kuyacarlo/tremor-pen/report/Tremor_Cue_Pen_Final_Project.docx

<LOGO>

Tremor Cue Pen: A Tremor-Detecting Pen Attachment with Haptic Feedback

Final Requirements in CPE306: Fundamentals of Mixed Signals and Sensors

Prepared by:

<Your Name>

Submitted to

ENGR. SHEILA MAY M. LIWAG

# Table of Contents

# A. Purpose and Overview

Hand tremor makes handwriting shaky and hard to read. Parkinsonian rest tremor usually sits around 4–6 Hz, and essential tremor, the more common cause of shaky handwriting, runs from about 4 to 12 Hz. The writer often cannot tell exactly when the tremor starts while they are concentrating on the words.

The Tremor Cue Pen is a 3D-printed cylinder that slides over an ordinary ballpen. Inside it, a motion sensor near the tip measures how the pen moves, firmware separates the slow movement of normal writing from the faster shaking of tremor, and a small vibration motor gives the writer a gentle buzz while tremor is present. The cue tells the writer to pause, slow down, or brace the hand.

What it does not do. The pen detects and cues; it does not cancel tremor. A coin vibration motor shakes at roughly 150–250 Hz and cannot push back against a 4–6 Hz movement, so active cancellation would need a different actuator and is outside this project.

## How it works

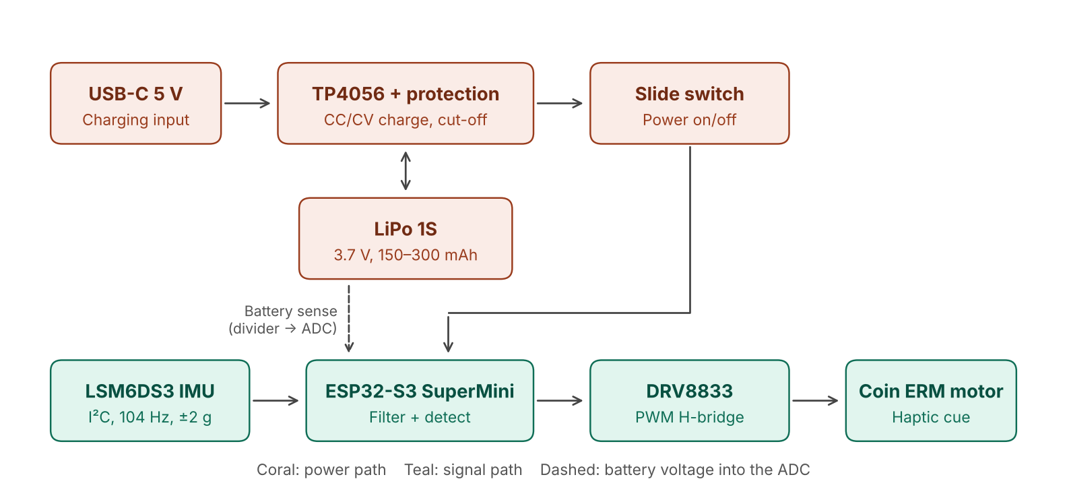
[picture p1: figure]

Figure 1. System block diagram

- Sense. The LSM6DS3 measures acceleration on three axes. Its internal converter samples at 104 Hz with a ±2 g range, and its built-in 50 Hz anti-aliasing filter removes fast vibration before the samples are read over I²C.
- Filter. The ESP32-S3 removes gravity, then runs every axis through two band-pass filters: a stroke band (0.5–3 Hz) for writing movement and a tremor band (4–12 Hz).
- Decide. The power in each band is averaged over about 1 s. Tremor is flagged when the tremor-band power is more than 3 times the stroke-band power and the tremor-band level is above 30 mg for half a second.
- Cue. While tremor is flagged, the ESP32-S3 sends PWM to the DRV8833 motor driver, which runs the coin motor at about one third power.
- Monitor. A voltage divider feeds the battery voltage to the ESP32-S3 ADC. Below 3.4 V the pen gives a three-pulse low-battery pattern.

## Hardware

Part | Role | Notes
ESP32-S3 SuperMini | Sampling, filtering, decision, PWM | Wi-Fi and Bluetooth off, CPU at 80 MHz to cut heat and current
LSM6DS3 6-axis IMU | Acceleration sensing | I²C address 0x6A; gyroscope used only for logging
DRV8833 dual H-bridge | Motor driver | AIN1 from PWM, AIN2 to GND, nSLEEP to 3V3
Coin ERM vibration motor | Haptic cue | 3 V; run at 350 of 1023 PWM because full power is too strong
LiPo 1S cell | Power | With protection PCB
TP4056 charger module | Charging and protection | USB-C input; overcharge and overdischarge cut-off
Slide switch | Power on/off | Between the charger output and the board
2 × 100 kΩ resistors, 100 nF capacitor | Battery sense divider and filter | Halves the battery voltage into the ADC range
3D-printed cylinder | Enclosure | Slides over a ballpen; IMU at the tip end, motor in foam

## Wiring

From | To | ESP32-S3 GPIO
LSM6DS3 SDA | I²C data | GPIO8
LSM6DS3 SCL | I²C clock | GPIO9
LSM6DS3 SDO, CS | GND and 3V3 (selects I²C, address 0x6A) | —
DRV8833 AIN1 | Motor PWM | GPIO4
Battery divider midpoint | ADC1 channel 0 | GPIO1

# B. Scope and Limitations

## Scope

- Detects hand tremor in the 4–12 Hz band in real time while the pen is used, with about 1 s of smoothing and 0.5 s of confirmation.
- Tells tremor apart from normal handwriting and drawing using the ratio of tremor-band to stroke-band power.
- Gives a haptic cue through a coin motor and a low-battery warning pattern.
- Runs on a rechargeable LiPo cell inside a cylinder attachment for a standard ballpen.
- Streams detector values or raw sensor data over USB for logging and analysis.

## Limitations

- Simulated tremor only. Tremor was simulated by deliberately shaking the hand at about 7 Hz. No recordings come from people with Parkinson’s disease or essential tremor, and the device makes no clinical claim.
- Tuned and tested on the same data. Thresholds were chosen on the same five recordings used to report the results, so those results are optimistic until checked on new recordings.
- Prototype rig. The detection recordings were made with the sensor strapped to the wrist on the NodeMCU prototype. The final ESP32-S3 pen uses the same sensor settings and algorithm, but the recordings must be repeated with the sensor in the pen.
- No cancellation. The pen cues the writer and does not reduce the tremor itself.
- False cues. Fast strokes and pen-lift jerks can still produce occasional false cues (about 2.5% of normal writing time).
- Motor feedback risk. The motor vibrates at 150–250 Hz, above the sensor’s 52 Hz Nyquist limit. Any vibration that passes the sensor’s anti-aliasing filter could fold back into the tremor band and keep the motor on. This must be checked with the motor coupling test (Section F).

## Future work

- Cue frequency as a check-up prompt. Counting tremor cues and their total duration over days or weeks could show whether tremor is frequent or getting worse. Above a set level, the pen could suggest that the user consult a physician, who can refer to a neurologist if needed. This would be a prompt to seek care, not a diagnosis, and its threshold would need validation on real users so that fast writers are not flagged. It is outside the scope of this study.

# C. Relevance in Fundamentals of Mixed Signals and Sensors

The project follows one physical quantity, hand acceleration, from a sensor to a digital decision and back out to a physical actuator. Each stage maps to a CPE306 topic.

CPE306 topic | Where it appears in the project
Sensors and transducers | MEMS capacitive accelerometer: a proof mass moves between fixed plates, changing capacitance with acceleration
Signal conditioning | Inside the IMU: charge amplifier, internal ADC, 50 Hz anti-aliasing low-pass; outside: RC filter on the battery divider
Sampling theorem | 104 Hz sampling gives a 52 Hz Nyquist limit, well above the 12 Hz tremor band edge
A/D conversion | IMU 16-bit output (±2 g, 0.061 mg per count); ESP32-S3 12-bit ADC for battery voltage with 16× averaging
D/A conversion | PWM duty cycle sets the average motor voltage (PWM acting as a 1-bit DAC with the motor as the low-pass load)
Digital signal processing | Second-order IIR biquad high-pass and low-pass filters, exponential averaging, ratio decision with hysteresis
Power switching devices | DRV8833 MOSFET H-bridge switched at 20 kHz
Measurement theory and calibration | Gravity reference at start-up, noise floor and 1 g magnitude check, threshold selection from recorded data

## Sensor and signal chain

The LSM6DS3 is a MEMS accelerometer. Acceleration moves a tiny suspended mass, the change in capacitance is converted to a voltage by an internal charge amplifier, filtered by an internal anti-aliasing low-pass, and digitised by the sensor’s own converter. The ESP32-S3 reads the result as 16-bit numbers over I²C, so all analog conditioning for the motion signal happens on the sensor chip. With the ±2 g range, one count is 0.061 mg.

The sensor was set to 104 samples per second. By the sampling theorem the highest frequency it can represent is 52 Hz, about four times the 12 Hz top of the tremor band. The internal 50 Hz anti-aliasing filter attenuates motion above that limit before it can fold back into the band of interest.

## Filtering

Each band-pass is a second-order high-pass followed by a second-order low-pass (Butterworth-like, Q = 0.707), computed from the bilinear-transform biquad formulas at fs = 104 Hz. The stroke band (0.5–3 Hz) holds the slow movement of writing; the tremor band (4–12 Hz) holds the shaking. Gravity is measured at start-up and subtracted from every sample so the filters do not ring at power-on.

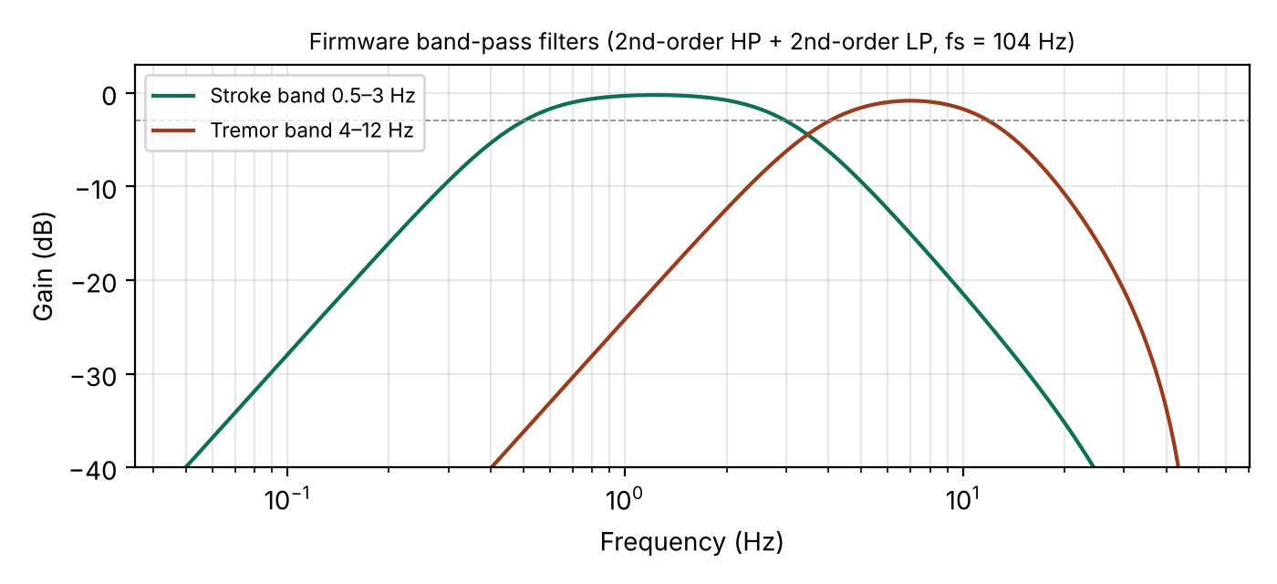
[picture p2: figure]

Figure 2. Frequency response of the two firmware band-pass filters

## Why a ratio and not a threshold

The first version of the firmware turned the motor on whenever the tremor-band level passed a fixed threshold. The recordings showed that normal handwriting itself puts energy in the 4–6 Hz range, so that version fired during 40% of normal writing. Tremor raises the tremor band relative to the stroke band, while writing raises the stroke band. The ratio of the two separates them even when their absolute levels overlap.

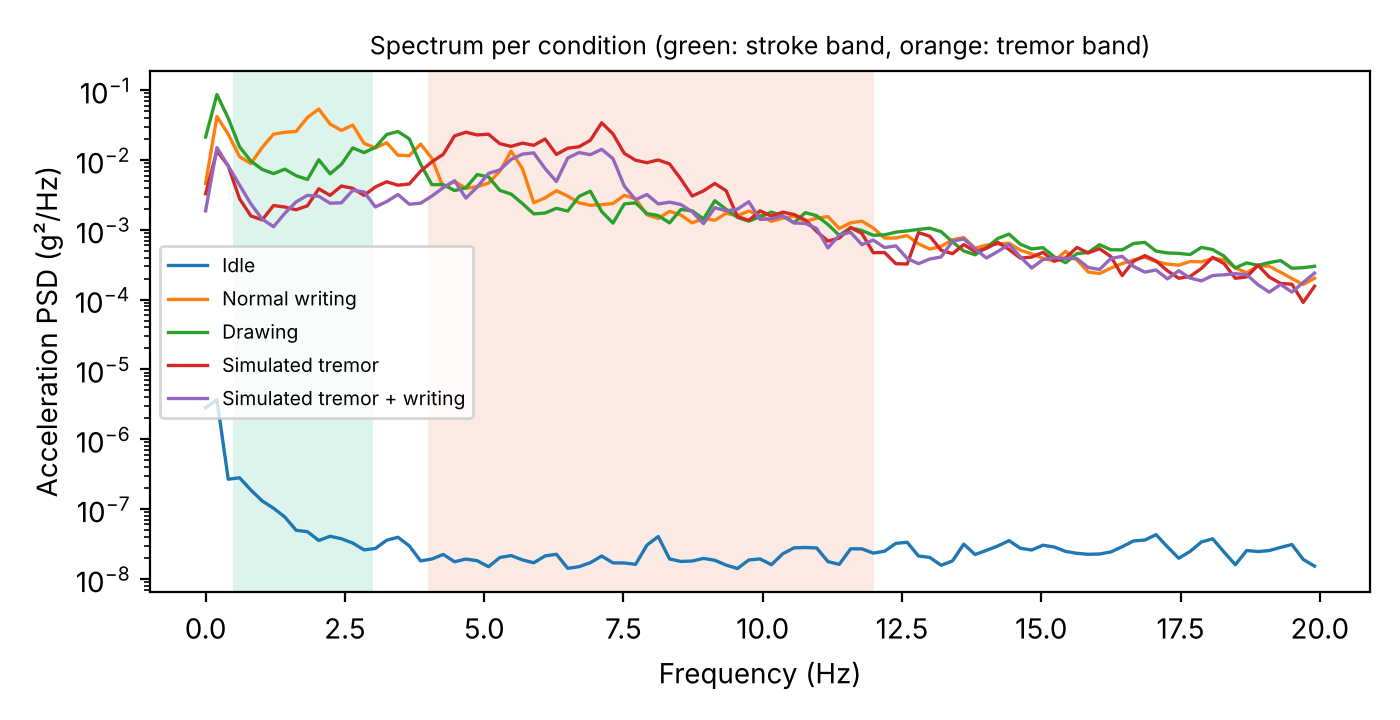
[picture p3: figure]

Figure 3. Acceleration spectrum per recording. Writing peaks inside the stroke band; simulated tremor peaks at about 7 Hz inside the tremor band.

## Analog-to-digital and digital-to-analog stages

Battery voltage (3.0–4.2 V) is above the ESP32-S3 ADC range, so two 100 kΩ resistors halve it and a 100 nF capacitor across the lower resistor filters switching noise. The firmware averages 16 readings, which lowers random noise by a factor of about 4 (2 bits), and reads calibrated millivolts with analogReadMilliVolts(). The divider draws about 21 µA at 4.2 V.

The ESP32-S3 has no DAC. Instead, the motor is driven with a 20 kHz PWM signal. The motor’s winding inductance and rotor inertia average the pulses, so the duty cycle acts as the output level: 350 of 1023 gives an average of about 34% of the supply voltage.

## Calibration and measurement

With the sensor still, the measured acceleration magnitude was 0.978 g against the expected 1 g, an error of about 2.2%. The noise standard deviation was 0.8, 0.6 and 3.7 mg on the three axes, and the tremor-band level at rest was below 1 mg, far under the 30 mg detection gate. Because the detector uses band-pass filtered signals, a constant offset or a gain error of a few percent does not change the decision. A six-orientation calibration (±1 g on each axis) can be added to measure offset and gain per axis.

## Alternatives considered

Decision | Options | Chosen and why
Motion sensor | Analog accelerometer (ADXL335) with external op-amp filter; digital IMU (LSM6DS3) | Digital IMU: built-in anti-aliasing and converter, low noise, I²C with two wires
Detection method | Tremor-band energy threshold; FFT peak frequency; tremor/stroke ratio; gyroscope energy | Ratio: fewest false cues on writing (2.5% vs 40%) and best detection while writing
Actuator | Coin ERM motor; linear resonant actuator (LRA); piezo buzzer | ERM: on hand, strong, simple to drive; LRA needs a dedicated driver
Controller | NodeMCU (ESP8266); ESP32-S3 SuperMini | ESP32-S3 for the final pen: smaller, more ADC channels, native USB; NodeMCU used for the prototype

Comparison of detection methods on the five recordings (percentage of time flagged after a 2.5 s warm-up):

Detector | Idle | Writing | Drawing | Tremor | Tremor + writing
Energy only (>170 mg) | 0% | 40% | 20% | 90% | 40%
Ratio detector | 0% | 2% | 0% | 100% | 82%

# D. User Interfaces

## Writer

The writer uses the pen like any ballpen. The only controls are the power switch and the USB-C charging port; all feedback is through vibration.

Event | What the writer feels | Condition
Power on | Nothing for about 1 s while the pen measures gravity | Hold the pen still at switch-on
Tremor detected | Continuous gentle buzz | Ratio > 3 and level > 30 mg for 0.5 s
Tremor stops | Buzz stops | Ratio < 1.5 or level < 20 mg for 0.5 s
Low battery | Three short pulses about every 10 s | Battery below 3.4 V
Charging | Charger LED on | USB-C connected

## Developer and tester

Over USB, the pen streams one line every 5 samples (about 20 lines per second). The Arduino Serial Plotter draws these as live graphs, and the Python logger saves them as labelled CSV files.

Field | Meaning
band_mg | Tremor-band level (smoothed RMS, mg)
on, off | Start and stop level gates (30 and 20 mg), drawn as reference lines
motor | 20 while the cue is on, 0 otherwise
ratio | Tremor-band ÷ stroke-band power
vbat | Battery voltage (V)

Setting LOG_RAW to 1 switches the stream to raw accelerometer and gyroscope counts for recording new data:

python record.py normal_writing 30 /dev/ttyACM0

# E. Code

Firmware for the ESP32-S3 SuperMini, written for the Arduino-ESP32 core 3.x (board “ESP32S3 Dev Module”, USB CDC On Boot enabled).

Setting | Value | Reason
Sample rate | 104 Hz | Sensor output rate, above twice the 12 Hz band edge
Stroke band | 0.5–3 Hz | Writing and arm movement
Tremor band | 4–12 Hz | Parkinsonian and essential tremor
Smoothing | α = 0.01 (about 1 s) | Longer smoothing reduced false cues
Start rule | Ratio > 3 and level > 30 mg for 0.5 s | Ratio rejects writing; level gate rejects sensor noise
Stop rule | Ratio < 1.5 or level < 20 mg for 0.5 s | Hysteresis prevents on/off chatter
Motor PWM | 350 of 1023 at 20 kHz | Full power is too strong; 20 kHz is silent

tremor_cue_pen.ino

// Tremor Cue Pen - ESP32-S3 SuperMini firmware

// LSM6DS3 accel (I2C) -> two band-pass chains -> tremor/stroke ratio -> DRV8833 PWM -> coin motor

// Arduino-ESP32 core 3.x. Board: "ESP32S3 Dev Module", USB CDC On Boot: Enabled.

#include <Wire.h>

#include <WiFi.h>

// ---------- pins (GPIO numbers, ESP32-S3 SuperMini) ----------

const int PIN_SDA = 8;

const int PIN_SCL = 9;

const int PIN_MOTOR = 4; // DRV8833 AIN1 (AIN2 -> GND, nSLEEP -> 3V3)

const int PIN_VBAT = 1; // ADC1_CH0, battery through 100k/100k divider + 100 nF

// ---------- settings ----------

#define LOG_RAW 0 // 1: stream raw accel/gyro for record.py, 0: stream detector values

const int IMU = 0x6A;

const float FS = 104.0f;

const float ALPHA = 0.01f; // power smoothing, time constant ~1 s

const float ON_RATIO = 3.0f, ON_MG = 30.0f;

const float OFF_RATIO = 1.5f, OFF_MG = 20.0f;

const int HOLD = (int)(0.5f * FS); // 0.5 s confirmation

const int MOTOR_PWM = 350; // of 1023

const float VBAT_LOW = 3.40f; // volts

const unsigned long PERIOD_US = (unsigned long)(1e6f / FS);

// ---------- 2nd-order biquad (RBJ, Q = 0.707) ----------

struct Biquad {

float b0, b1, b2, a1, a2, z1 = 0, z2 = 0;

void set(bool hp, float f) {

float w = 2 * PI * f / FS, c = cosf(w), al = sinf(w) / (2 * 0.707f), a0 = 1 + al;

if (hp) { b0 = (1 + c) / 2; b1 = -(1 + c); } else { b0 = (1 - c) / 2; b1 = 1 - c; }

b2 = b0; b0 /= a0; b1 /= a0; b2 /= a0; a1 = -2 * c / a0; a2 = (1 - al) / a0;

z1 = z2 = 0;

}

float run(float x) {

float y = b0 * x + z1;

z1 = b1 * x - a1 * y + z2;

z2 = b2 * x - a2 * y;

return y;

}

};

struct BandPass {

Biquad hp, lp;

void set(float lo, float hi) { hp.set(true, lo); lp.set(false, hi); }

float run(float x) { return lp.run(hp.run(x)); }

};

BandPass tremorBP[3], strokeBP[3];

float g0[3]; // gravity reference, removed before filtering (primes the filters)

float pTremor = 0, pStroke = 0;

bool flagged = false;

int holdCount = 0;

unsigned long nextT;

int16_t lastRaw[3]; int frozenCount = 0;

// ---------- IMU ----------

void wr(uint8_t reg, uint8_t v) {

Wire.beginTransmission(IMU); Wire.write(reg); Wire.write(v); Wire.endTransmission();

}

bool rd(uint8_t reg, uint8_t *buf, int n) {

Wire.beginTransmission(IMU); Wire.write(reg);

if (Wire.endTransmission(false) != 0) return false;

if (Wire.requestFrom(IMU, n) != n) return false;

for (int i = 0; i < n; i++) buf[i] = Wire.read();

return true;

}

bool imuInit() {

uint8_t id = 0;

if (!rd(0x0F, &id, 1) || (id != 0x69 && id != 0x6A)) { Serial.printf("bad WHO_AM_I 0x%02X\n", id); return false; }

wr(0x12, 0x44); // CTRL3_C: auto-increment, block data update

wr(0x10, 0x43); // CTRL1_XL: 104 Hz, +/-2 g, 50 Hz anti-alias bandwidth

wr(0x11, 0x40); // CTRL2_G: gyro 104 Hz, 245 dps (logging only)

return true;

}

bool readIMU(int16_t a[3], int16_t g[3]) {

uint8_t b[12];

if (!rd(0x22, b, 12)) return false; // OUTX_L_G .. OUTZ_H_XL

for (int i = 0; i < 3; i++) {

g[i] = (int16_t)((b[2 * i + 1] << 8) | b[2 * i]);

a[i] = (int16_t)((b[2 * i + 7] << 8) | b[2 * i + 6]);

}

return true;

}

void resetFilters() {

for (int i = 0; i < 3; i++) { tremorBP[i].set(4.0f, 12.0f); strokeBP[i].set(0.5f, 3.0f); }

// average 32 samples to get the gravity reference

float s[3] = {0, 0, 0}; int n = 0; int16_t a[3], g[3];

while (n < 32) { if (readIMU(a, g)) { for (int i = 0; i < 3; i++) s[i] += a[i] * 0.000061f; n++; } delay(10); }

for (int i = 0; i < 3; i++) g0[i] = s[i] / n;

pTremor = pStroke = 0; flagged = false; holdCount = 0;

}

// ---------- battery (ADC) ----------

float readVbat() {

uint32_t mv = 0;

for (int i = 0; i < 16; i++) mv += analogReadMilliVolts(PIN_VBAT); // 16x averaging

return (mv / 16.0f) * 2.0f / 1000.0f; // undo 1:2 divider

}

void setup() {

WiFi.mode(WIFI_OFF);

btStop();

setCpuFrequencyMhz(80);

Serial.begin(115200);

delay(500);

Wire.begin(PIN_SDA, PIN_SCL);

Wire.setClock(400000);

analogReadResolution(12);

analogWriteResolution(PIN_MOTOR, 10);

analogWriteFrequency(PIN_MOTOR, 20000); // above hearing

analogWrite(PIN_MOTOR, 0);

while (!imuInit()) delay(500);

resetFilters();

nextT = micros();

}

void loop() {

if ((long)(micros() - nextT) < 0) return;

nextT += PERIOD_US;

int16_t a[3], g[3];

if (!readIMU(a, g)) { Serial.println("i2c fail"); analogWrite(PIN_MOTOR, 0); delay(100); imuInit(); resetFilters(); nextT = micros(); return; }

bool same = a[0] == lastRaw[0] && a[1] == lastRaw[1] && a[2] == lastRaw[2];

frozenCount = same ? frozenCount + 1 : 0;

memcpy(lastRaw, a, sizeof(lastRaw));

if (frozenCount > 50) { Serial.println("frozen, reinit"); imuInit(); resetFilters(); frozenCount = 0; nextT = micros(); return; }

#if LOG_RAW

Serial.printf("raw,%lu,%d,%d,%d,%d,%d,%d\n", millis(), a[0], a[1], a[2], g[0], g[1], g[2]);

#endif

float eT = 0, eS = 0;

for (int i = 0; i < 3; i++) {

float x = a[i] * 0.000061f - g0[i]; // g, gravity removed

float yt = tremorBP[i].run(x), ys = strokeBP[i].run(x);

eT += yt * yt; eS += ys * ys;

}

pTremor += ALPHA * (eT - pTremor);

pStroke += ALPHA * (eS - pStroke);

float rmsMg = sqrtf(pTremor) * 1000.0f;

float ratio = pTremor / (pStroke + 1e-12f);

if (!flagged) {

holdCount = (ratio > ON_RATIO && rmsMg > ON_MG) ? holdCount + 1 : 0;

if (holdCount >= HOLD) { flagged = true; holdCount = 0; }

} else {

holdCount = (ratio < OFF_RATIO || rmsMg < OFF_MG) ? holdCount + 1 : 0;

if (holdCount >= HOLD) { flagged = false; holdCount = 0; }

}

static uint32_t n = 0; n++;

static float vbat = 4.0f;

if (n % 104 == 0) vbat = readVbat(); // once per second

bool low = vbat < VBAT_LOW;

// low battery: three short pulses every ~10 s instead of tremor cues

int duty = 0;

if (low) { uint32_t k = n % 1040; duty = (k < 10 || (k > 20 && k < 30) || (k > 40 && k < 50)) ? MOTOR_PWM : 0; }

else duty = flagged ? MOTOR_PWM : 0;

analogWrite(PIN_MOTOR, duty);

#if !LOG_RAW

if (n % 5 == 0)

Serial.printf("band_mg:%.1f,on:%d,off:%d,motor:%d,ratio:%.2f,vbat:%.2f\n", rmsMg, (int)ON_MG, (int)OFF_MG, flagged ? 20 : 0, ratio, vbat);

#endif

}

record.py (data logger)

#!/usr/bin/env python3

"""Usage: python record.py <label> [seconds=30] [port=/dev/ttyUSB0]

Logs either sketch mode:

LOG_RAW 1 -> <label>_raw_<ts>.csv (label,t_pc,t_ms,ax,ay,az,gx,gy,gz raw LSB)

LOG_RAW 0 -> <label>_band_<ts>.csv (label,elapsed_s,band_mg,on,off,motor)

"""

import csv, sys, time

import serial

label = sys.argv[1] if len(sys.argv) > 1 else "normal_writing"

duration = float(sys.argv[2]) if len(sys.argv) > 2 else 30

port = sys.argv[3] if len(sys.argv) > 3 else "/dev/ttyUSB0"

ts = int(time.time())

RAW_HDR = ["label", "t_pc", "t_ms", "ax", "ay", "az", "gx", "gy", "gz"]

BAND_HDR = ["label", "elapsed_s", "band_mg", "on", "off", "motor"]

with serial.Serial(port, 115200, timeout=0.2) as s:

time.sleep(2) # let the board settle after the port opens

s.reset_input_buffer() # drop backlog so t=0 is really t=0

s.readline() # discard a possibly partial line

t0 = time.monotonic()

next_status = 0.0

f = writer = None

n = 0

try:

while True:

el = time.monotonic() - t0

if el >= duration:

break

if el >= next_status:

print(f"\rRecording {label}: {max(0, duration-el):4.1f}s left, {n} rows", end="", flush=True)

next_status = el + 0.5

line = s.readline().decode(errors="ignore").strip()

row = None

if line.startswith("raw,"):

p = line.split(",")

if len(p) == 8:

try:

[int(x) for x in p[1:]]

except ValueError:

continue

row = ("raw", [label, f"{el:.3f}"] + p[1:])

elif line.startswith("band_mg:"):

try:

d = dict(i.split(":", 1) for i in line.split(","))

row = ("band", [label, f"{el:.2f}", d["band_mg"], d["on"], d["off"], d["motor"]])

except (ValueError, KeyError):

continue

if row is None:

if line:

print(f"\n[{line}]") # surface 'i2c fail', 'frozen, reinit', 'bad WHO_AM_I'

continue

if writer is None:

kind = row[0]

fn = f"{label}_{kind}_{ts}.csv"

f = open(fn, "w", newline="")

writer = csv.writer(f)

writer.writerow(RAW_HDR if kind == "raw" else BAND_HDR)

writer.writerow(row[1]); n += 1

except KeyboardInterrupt:

print("\nInterrupted.")

finally:

if f:

f.close()

print(f"\nSaved {fn if writer else '(nothing - no data lines seen)'} ({n} rows)")

# F. Use/Test Cases (Testing)

Five 30 s recordings were made with the sensor strapped to the wrist (NodeMCU prototype, same sensor settings). The firmware’s filters and decision rules were then replayed on the raw data. Percentages are the share of time the cue was on, after a 2.5 s warm-up.

ID | Test case | Expected | Result | Status
TC1 | Pen at rest on the table | No cue (0%) | 0% | Pass
TC2 | Normal handwriting | Cue ≤ 5% of the time | 2.5% | Pass
TC3 | Drawing shapes | Cue ≤ 5% of the time | 0% | Pass
TC4 | Simulated tremor, no writing | Cue ≥ 90% of the time | 100% | Pass
TC5 | Simulated tremor while writing | Cue ≥ 70% of the time | 82% | Pass
TC6 | Two new writing runs (new words), held out | Cue ≤ 5% | Pending | Pending
TC7 | Weak simulated tremor, held out | Cue ≥ 50% | Pending | Pending
TC8 | Motor forced on, pen still | Ratio and level stay below start rule | Pending | Pending
TC9 | TC1–TC5 repeated with sensor in the pen cylinder | Same limits as TC1–TC5 | Pending | Pending
TC10 | Battery below 3.4 V (bench supply) | Three-pulse pattern | Pending | Pending
TC11 | Unplug IMU while running, then reconnect | Motor off, sensor re-initialised | Pending | Pending

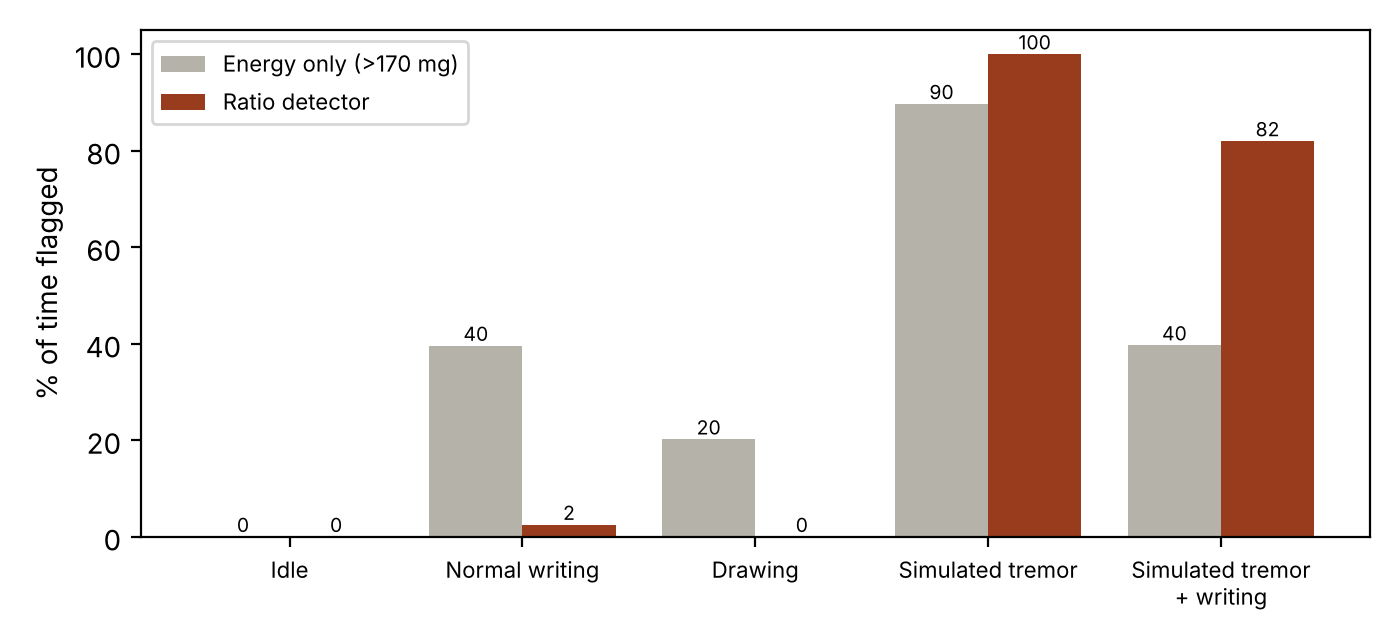
[picture p4: figure]

Figure 4. Share of time flagged: energy-only threshold against the ratio detector

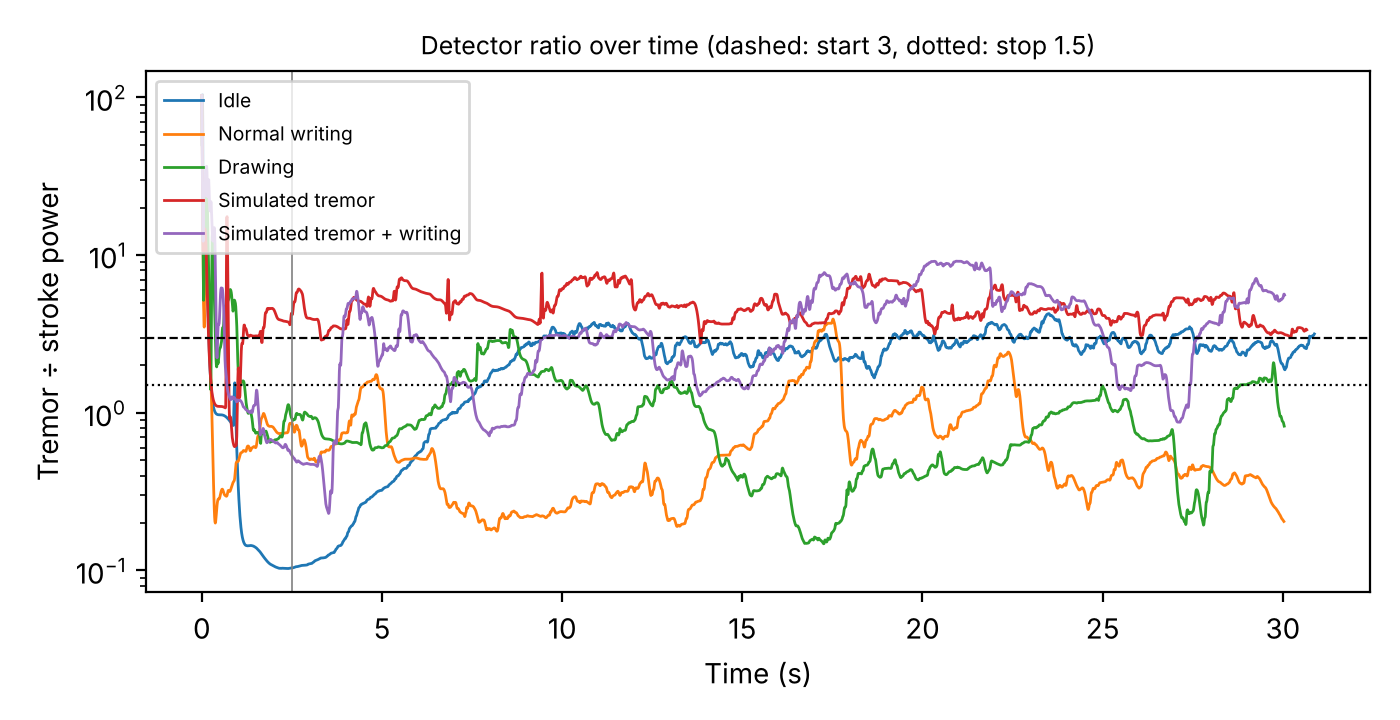
[picture p5: figure]

Figure 5. Detector ratio over each 30 s recording. Simulated tremor stays above the start line; writing and drawing stay below it.

## Signal summary per recording

Recording | Dominant frequency | Median ratio | Median tremor-band level
Idle | 0.6 Hz | 2.62 | 0.4 mg
Normal writing | 2.0 Hz | 0.49 | 154.2 mg
Drawing | 3.5 Hz | 0.78 | 116.8 mg
Simulated tremor | 7.1 Hz | 4.69 | 254.7 mg
Simulated tremor + writing | 7.1 Hz | 3.12 | 141.6 mg

At rest the ratio is around 2–3 because both bands contain only sensor noise, which is why the 30 mg level gate is part of the start rule: the tremor-band level at rest is under 1 mg, so the pen never cues while idle.

The simulated tremor peaks at about 7 Hz, the shaking rate used during recording, while normal writing peaks at 2 Hz inside the stroke band. All recordings ran at about 104 Hz with no lost samples.

Tremor Cue Pen
