kuyacarlo/tremor-pen/cad/stl/tremor_pen_pod_v7-cap.stl

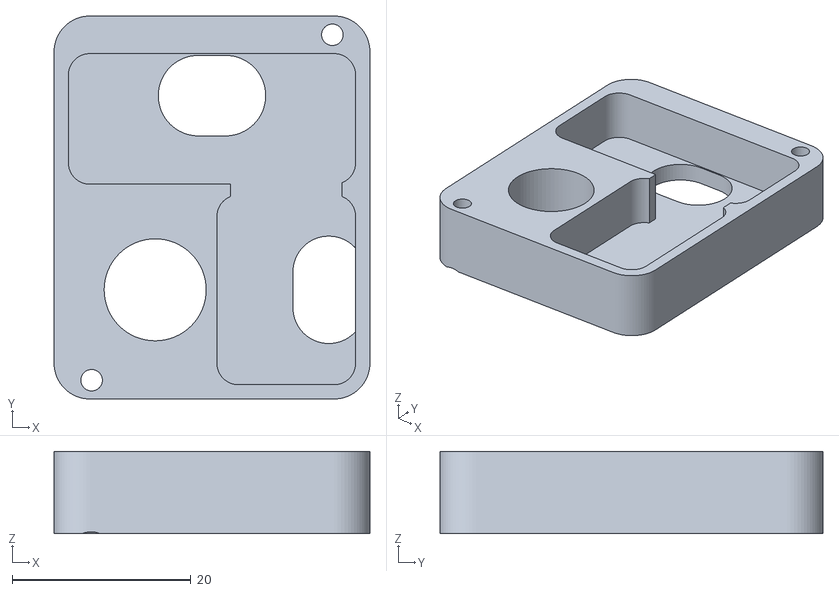
[picture p6: CAD file, 2026-11-03]
cad/stl/tremor_pen_pod_v7-cap.stl
35.3 x 42.8 x 9.20
