kuyacarlo/tremor-pen/cad/stl/tremor_pen_pod_v5-cover.stl

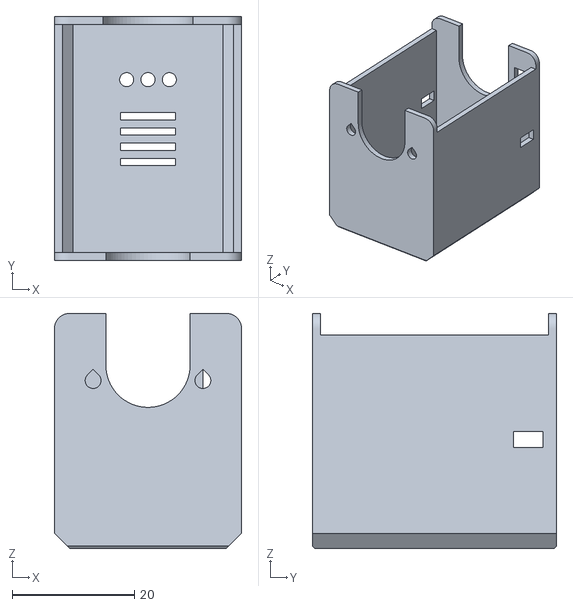
[picture p8: CAD file, 2026-11-03]
cad/stl/tremor_pen_pod_v5-cover.stl
30.7 x 40.0 x 38.5
