kuyacarlo/tremor-pen/cad/stl/tremor_pen_pod_v5-base.stl

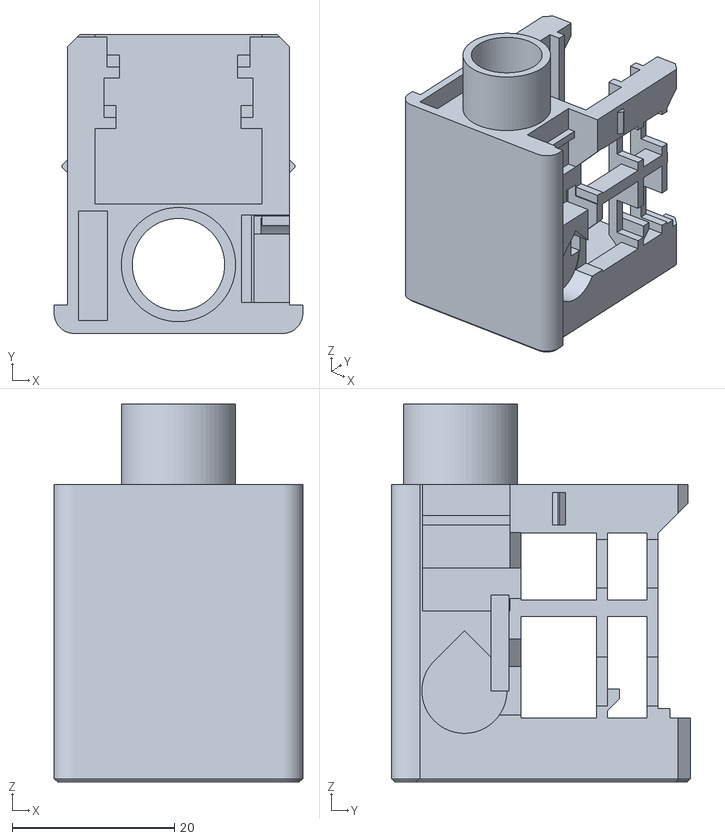
[picture p9: CAD file, 2026-11-03, an earlier design]
cad/stl/tremor_pen_pod_v5-base.stl
30.7 x 36.9 x 46.7
