kuyacarlo/tremor-pen/(list of files, cad)

Other CAD files:
cad/tremor_pen_pod_v5.scad
cad/archive/tremor_pen_pod_b.scad
cad/archive/tremor_pen_pod_v3_1.scad
cad/archive/tremor_pen_pod_v4.scad
cad/archive/tremor_pen_pod_v5.scad
cad/archive/tremor_pen_pod_v6.scad
