kuyacarlo/tremor-pen/cad/guide/assembly_v5.png

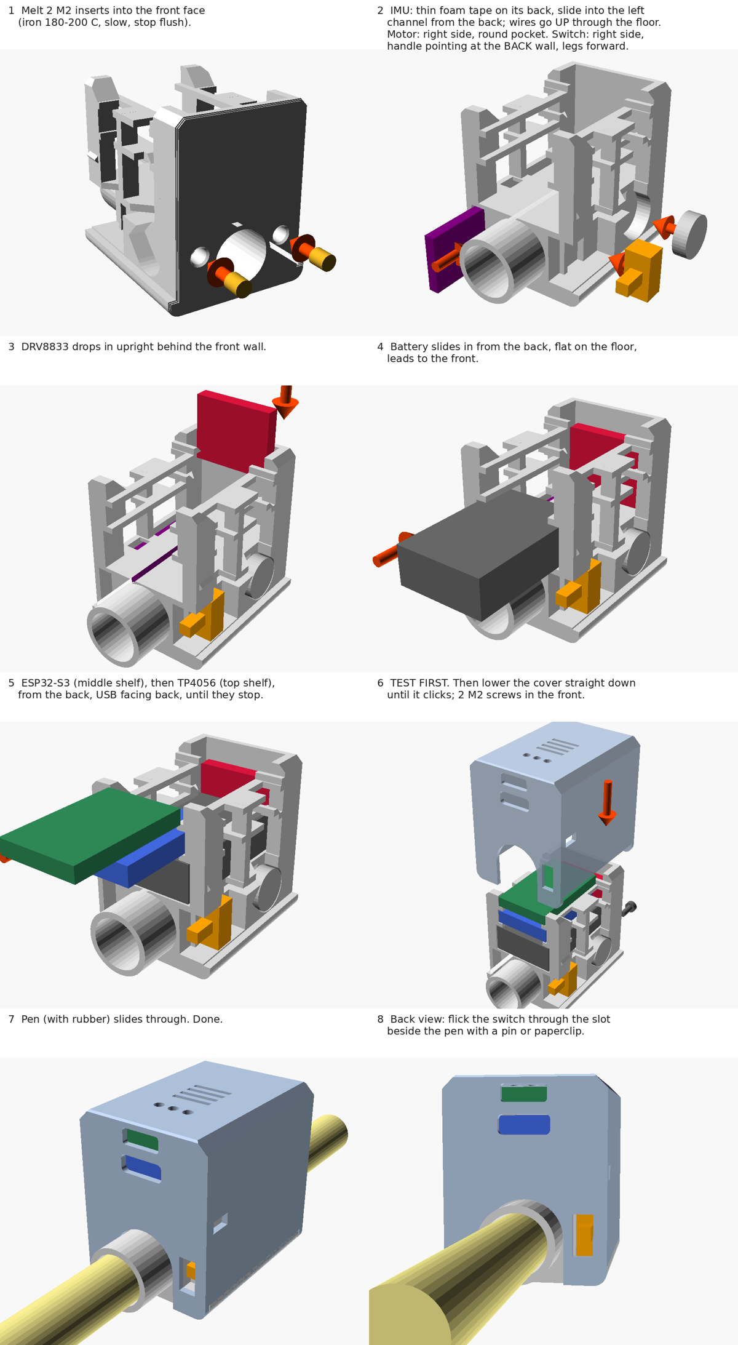
cad/guide/assembly_v5.png
