kuyacarlo/tremor-pen/(commit log)

2026-11-03 Initial commit: Tremor Cue Pen CPE306 final project
    Pen-mounted tremor-detection pod with IMU-based 4-12 Hz tremor/stroke
    band detector, NodeMCU bench + ESP32-S3 final firmware, OpenSCAD pod
    design, recorded test data, and project report.
    [drawing_raw_1793138485.csv, fake_tremor_raw_1793138380.csv, fake_tremor_writing_raw_1793138448.csv, idle_raw_1793138091.csv, normal_writing_raw_1793138334.csv, steps.scad, tremor_pen_pod_b.scad, tremor_pen_pod_v3_1.scad]
2026-11-03 Add WROOM-32 firmware variant, fix NodeMCU I2C pins, pulse-mode motor cue
    - NodeMCU: switch from low/medium/high motor levels to full-strength
    pulse + refractory cueing (fixes motor vibration false-retriggering
    the tremor detector through the IMU); I2C moved to D6/D7 (non-strapping
    pins) after D8 caused boot issues.
    - New firmware/esp32-wroom32/tremor_cue_wroom32.ino for bench testing
    on a classic ESP32-WROOM-32 DevKit.
    - ESP32-S3: VBAT_LOW disabled (battery-sense divider not fitted) and
    onboard RGB LED turned off at boot.
    [tremor_cue_nodemcu.ino, tremor_cue_wroom32.ino]
2026-11-03 Add v7 pod STLs, NodeMCU light-sleep between samples
    - cad/stl: v7 base/cap STL exports (validated via verify-model.py gate)
    - firmware/nodemcu: light sleep (LIGHT_SLEEP_T) during the idle wait
    between IMU samples instead of busy-spinning
    [tremor_pen_pod_v7-base.stl, tremor_pen_pod_v7-cap.stl]
2026-11-04 Add v7 pod source, archive v5/v6, fix stale DRV8833 comments, update CLAUDE.md
    - cad/tremor_pen_pod_v7.scad is now current (NodeMCU + IMU + vibration
    module stack); v5 and v6 moved to cad/archive/.
    - firmware/nodemcu: fixed wiring comments that still referenced a DRV8833
    motor driver, which isn't used - the vibration module drives itself.
    - CLAUDE.md rewritten to reflect the actual final hardware (NodeMCU, no
    S3, no DRV8833) and flag the two report test cases (TC8, TC10) that need
    attention before they can be trusted.
    [tremor_pen_pod_v5.scad, tremor_pen_pod_v6.scad, tremor_pen_pod_v7.scad]
